vattern/stoutgatv2/ISO-enter.png

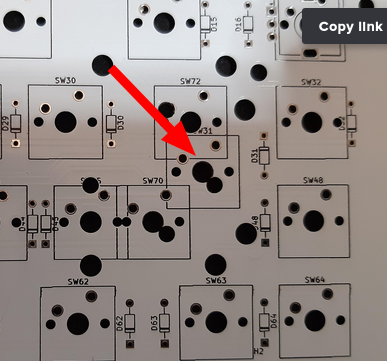
ISO-enter.png
