vattern/stoutgatv2/case/3d-print/Shell.stl

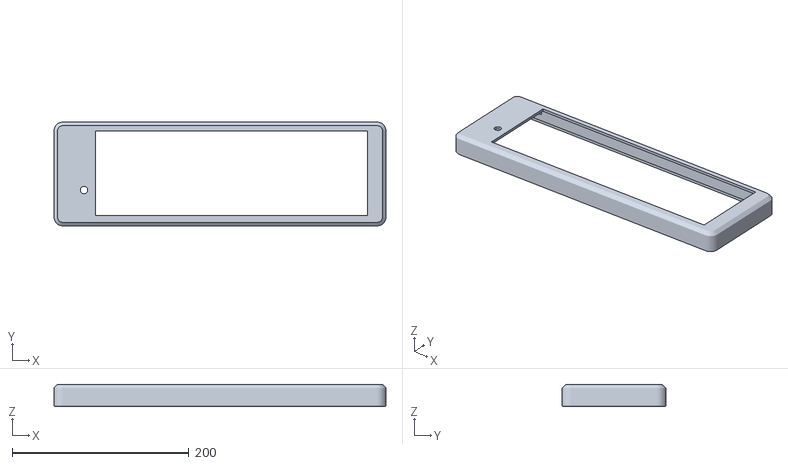
[picture p2: CAD file, 2021-02-21]
case/3d-print/Shell.stl
375.7 x 117.5 x 25.0
