vattern/stoutgatv2/case/acrylic/acrylic-layers.dxf

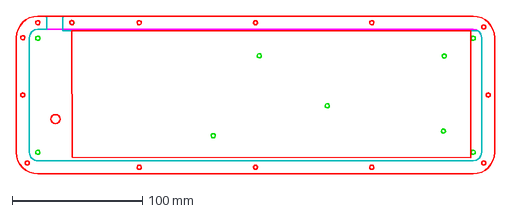
[picture p3: CAD file, 2021-02-21]
case/acrylic/acrylic-layers.dxf
366.8 x 121.0 mm
