vattern/stoutgatv2/gerbers/stoutgat-outline-Edge_Cuts.dxf

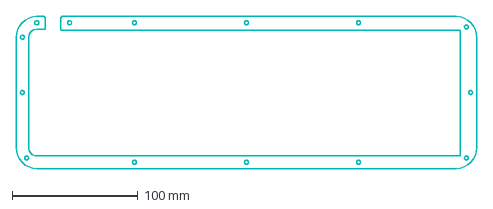
[picture p4: CAD file, 2020-09-12]
gerbers/stoutgat-outline-Edge_Cuts.dxf
366.8 x 121.0 mm
