vattern/stoutgatv2/stoutgatv2.step

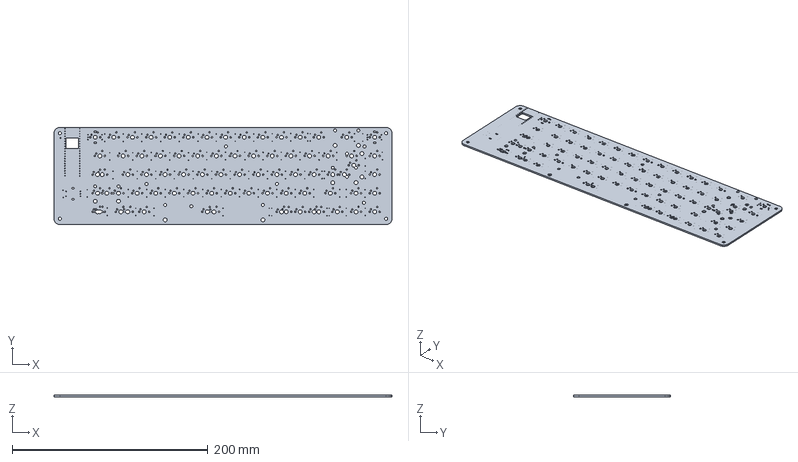
[picture p5: CAD file, 2020-09-12]
stoutgatv2.step
345.7 x 99.5 x 1.60 mm
