vattern/stoutgatv2/case/3d-print/Base.stl

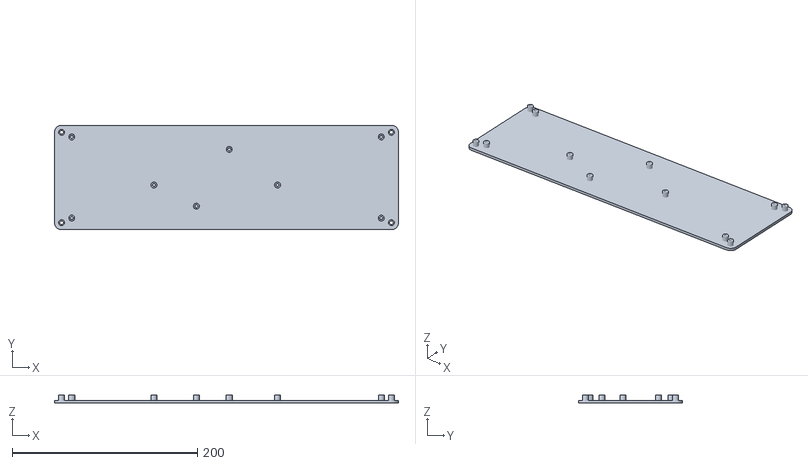
[picture p6: CAD file, 2021-02-21]
case/3d-print/Base.stl
370.9 x 112.7 x 9.00
