vattern/stoutgatv2/gerbers/stoutgatv2-Edge_Cuts.dxf

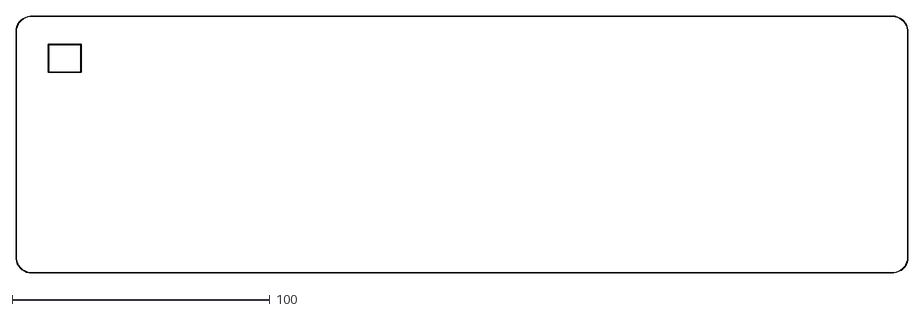
[picture p7: CAD file, 2020-08-15]
gerbers/stoutgatv2-Edge_Cuts.dxf
345.8 x 99.5
