vattern/stoutgatv2/case/3d-print/old-version-ymmv/bottom - left.stl

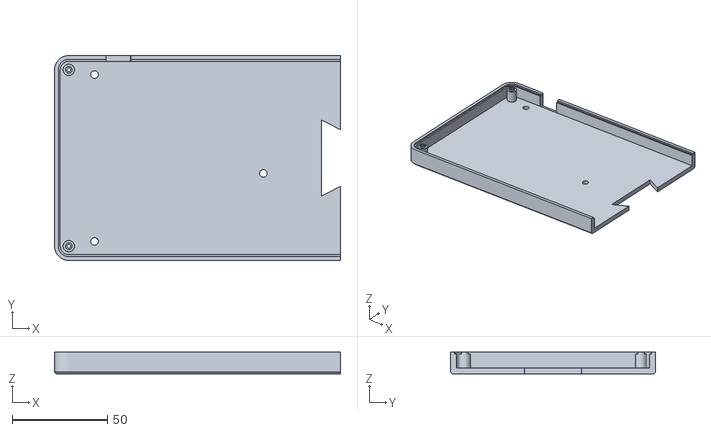
[picture p8: CAD file, 2020-09-12, an earlier design]
case/3d-print/old-version-ymmv/bottom - left.stl
150.0 x 107.5 x 11.5
