vattern/stoutgatv2/case/3d-print/old-version-ymmv/bottom-mid.stl

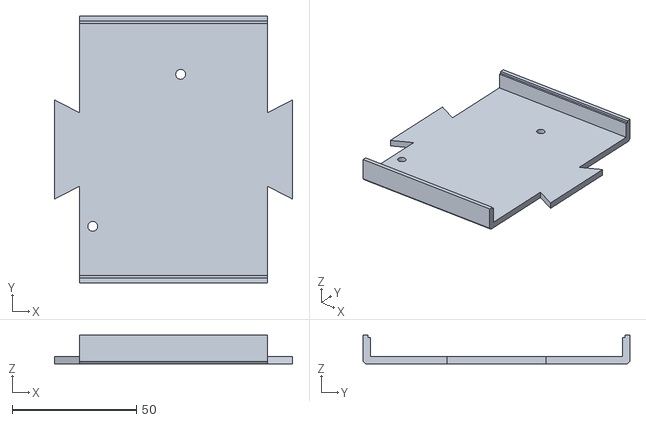
[picture p9: CAD file, 2020-09-12, an earlier design]
case/3d-print/old-version-ymmv/bottom-mid.stl
95.9 x 107.5 x 11.5
