vattern/stoutgatv2/case/3d-print/old-version-ymmv/top mid rear.stl

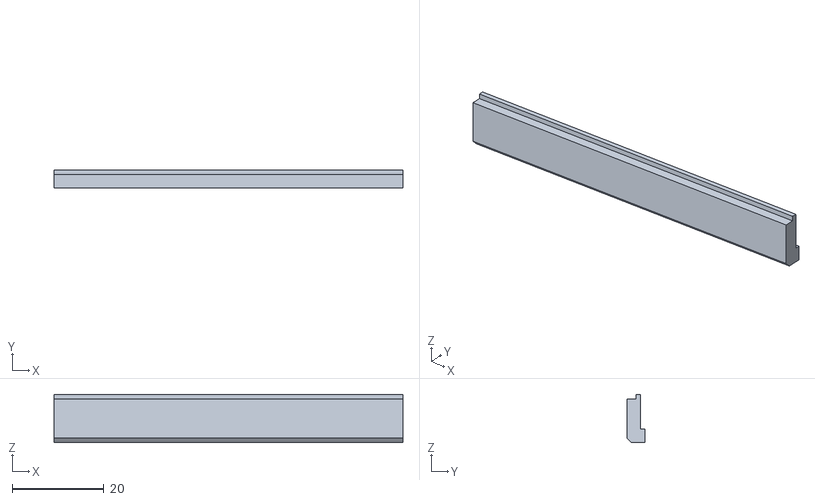
[picture p10: CAD file, 2020-09-12, an earlier design]
case/3d-print/old-version-ymmv/top mid rear.stl
75.9 x 4.00 x 10.5
