vattern/stoutgatv2/case/3d-print/old-version-ymmv/top - right.stl

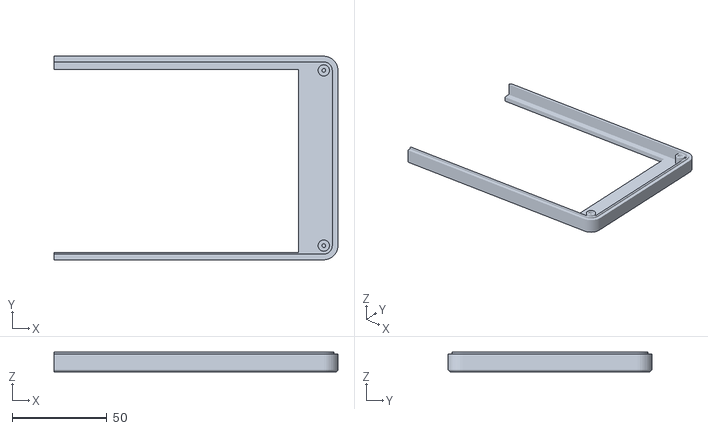
[picture p11: CAD file, 2020-09-12, an earlier design]
case/3d-print/old-version-ymmv/top - right.stl
149.8 x 107.5 x 10.5
