vattern/stoutgatv2/case/3d-print/old-version-ymmv/top - left.stl

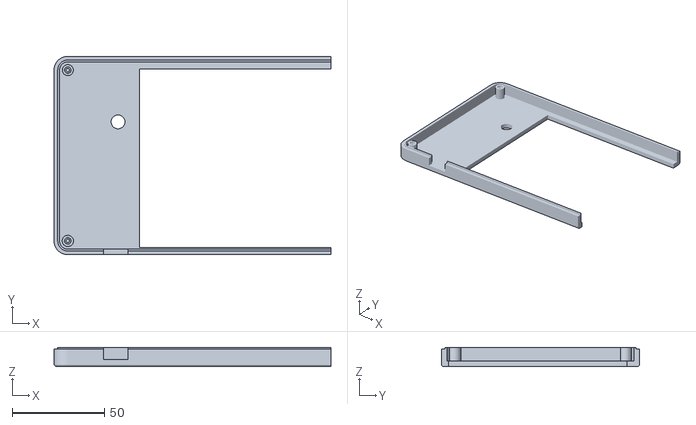
[picture p12: CAD file, 2020-09-12, an earlier design]
case/3d-print/old-version-ymmv/top - left.stl
150.0 x 107.5 x 10.5
