vattern/stoutgatv2/case/3d-print/old-version-ymmv/top mid front.stl

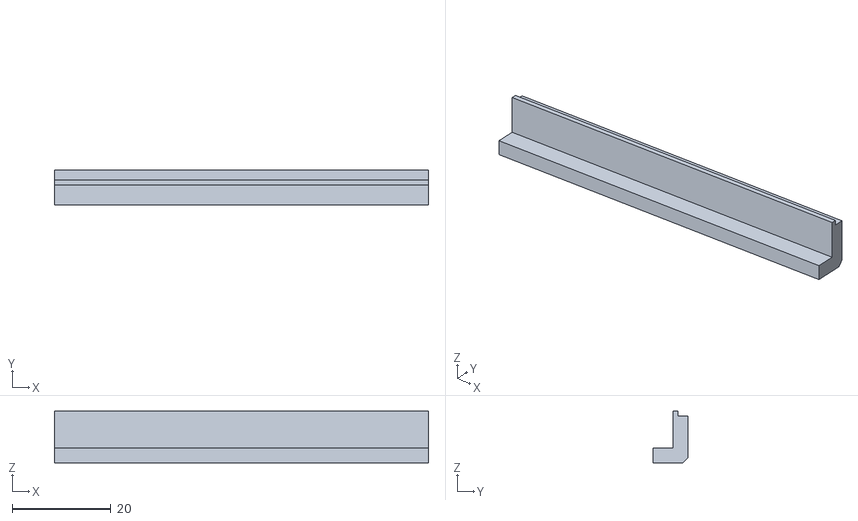
[picture p13: CAD file, 2020-09-12, an earlier design]
case/3d-print/old-version-ymmv/top mid front.stl
75.9 x 7.00 x 10.5
