vattern/stoutgatv2/(list of files, cad)

Other CAD files:
gerbers/stoutgat-outline-Dwgs_User.dxf
case/3d-print/old-version-ymmv/bottom - right.stl
case/3d-print/old-version-ymmv/stoutgatv2 v20.f3d
gerbers/#stoutgat-outline-Edge_Cuts.dxf
