vattern/stoutgatv2/stoutgatv2.kicad_pcb

## KiCad design stoutgatv2.kicad_pcb (2020-09-12)

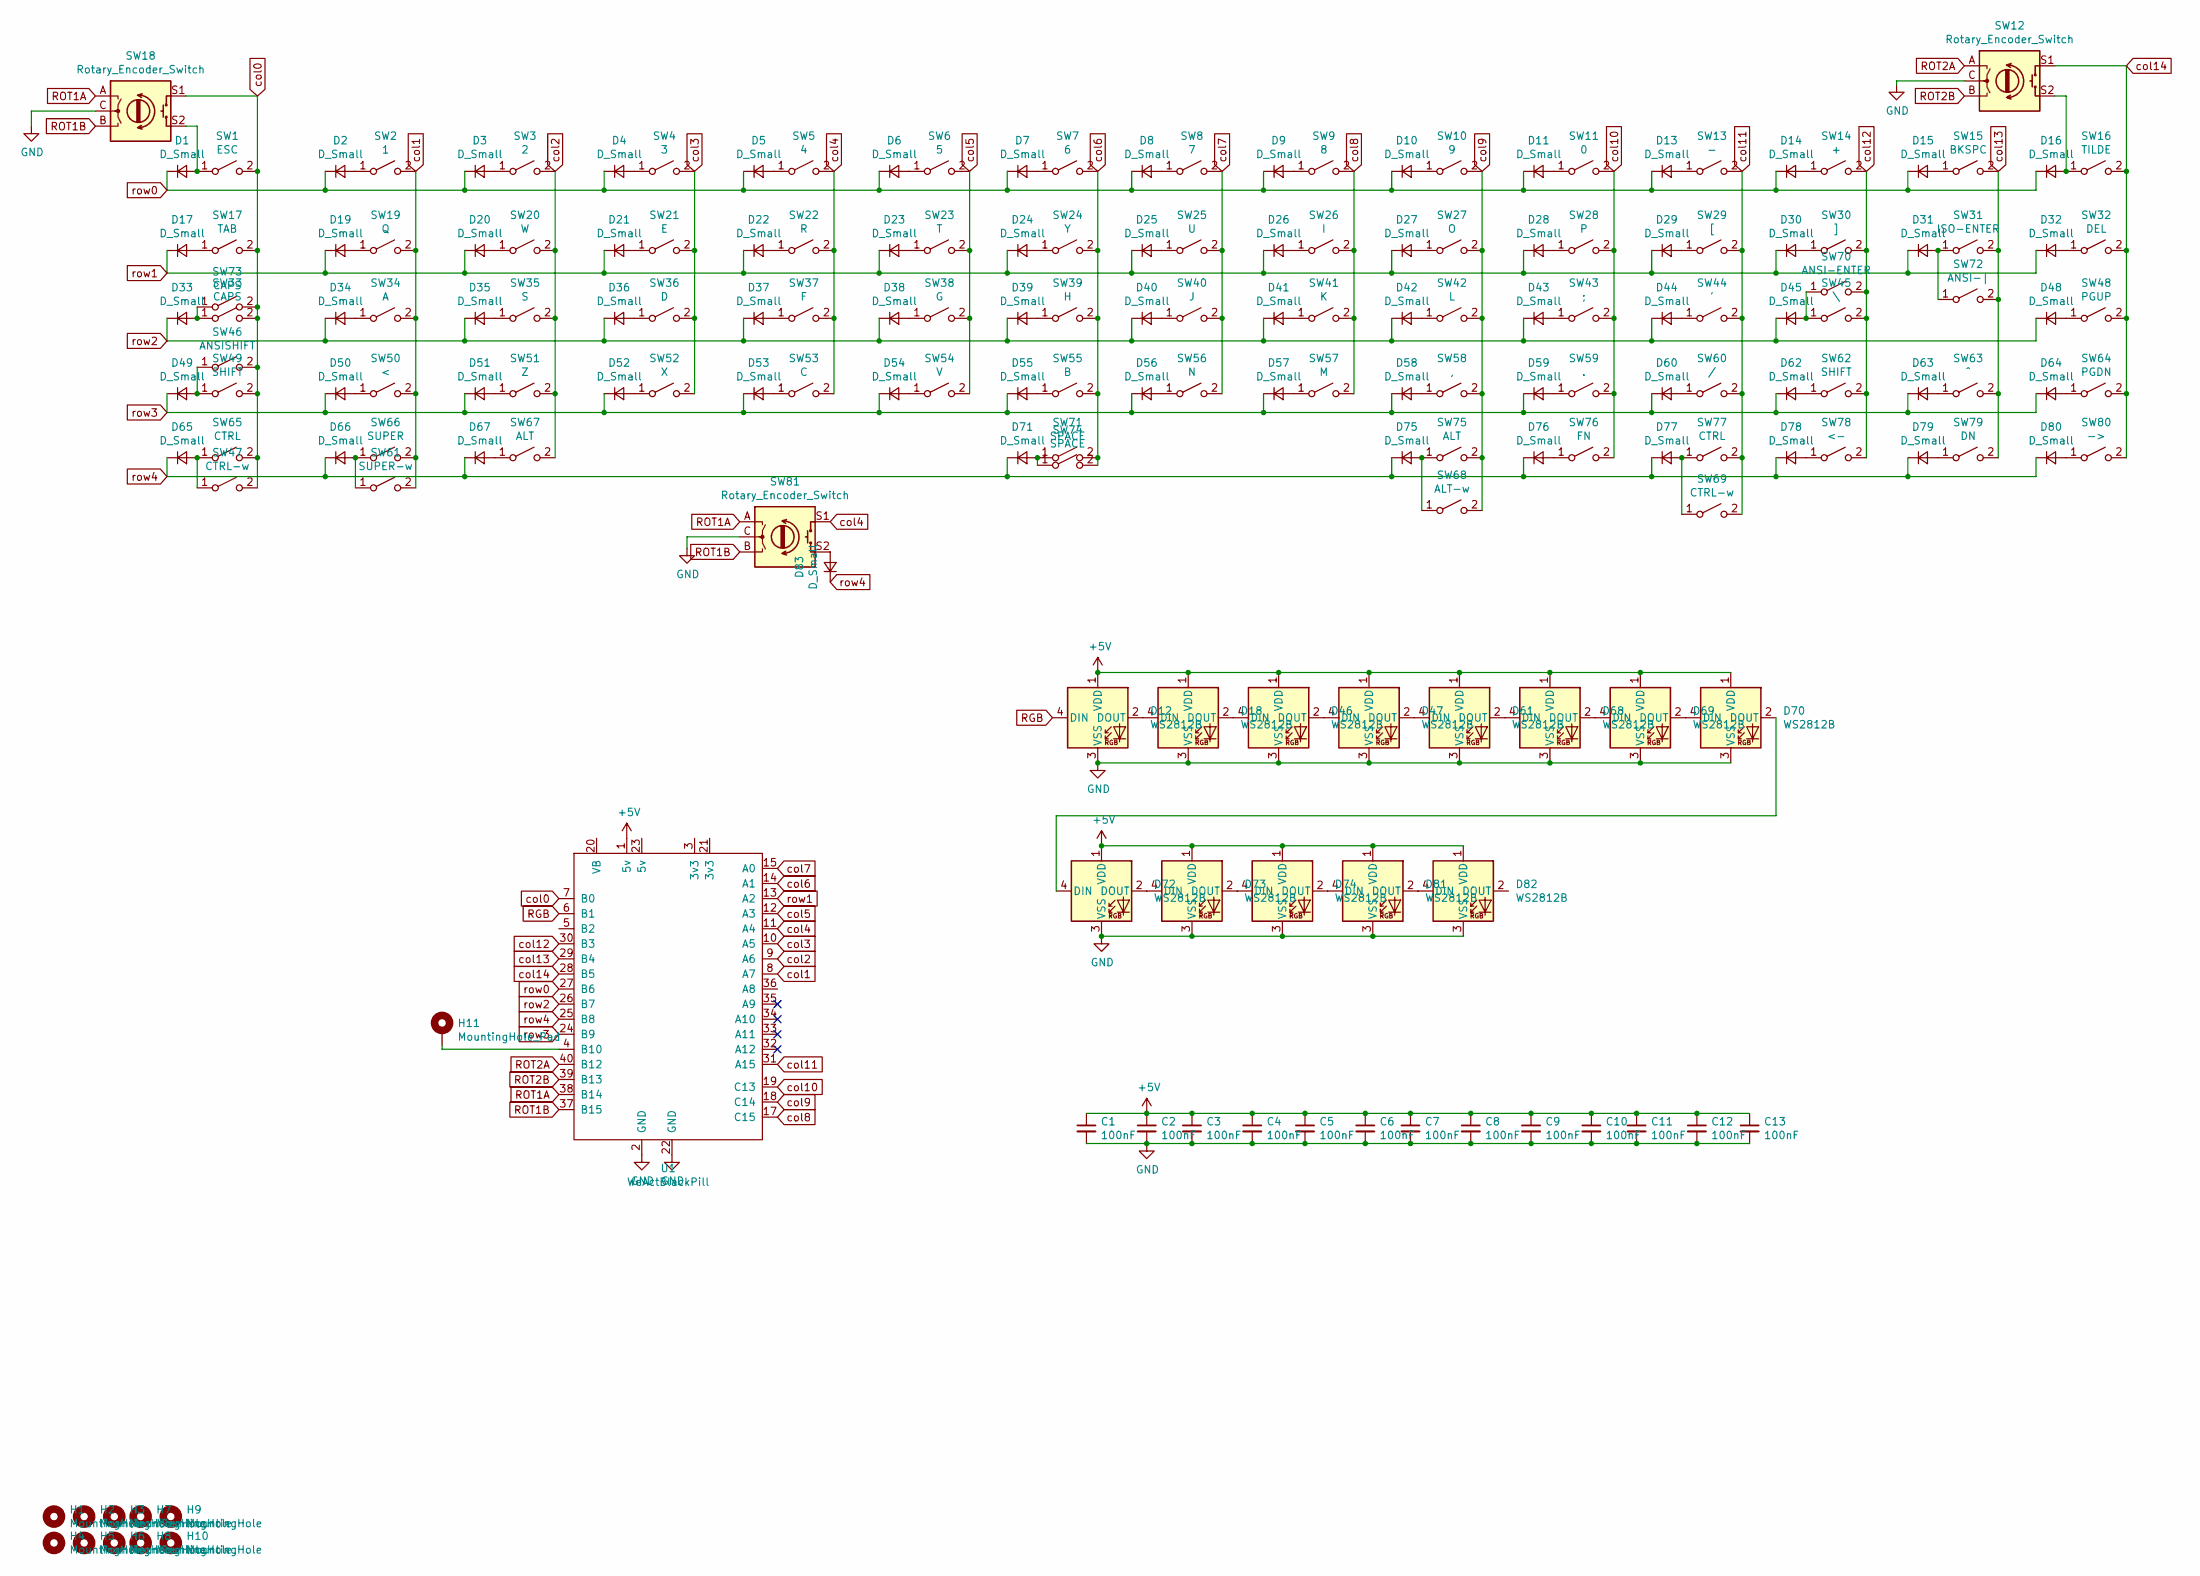
[picture p14: schematic stoutgatv2.sch, Stoutgat]

Parts:
C1, C2, C3, C4, C5, C6, C7, C8, C9, C10, C11, C12, C13: 100nF; C_0805_2012Metric
D1, D2, D3, D4, D5, D6, D7, D8, D9, D10, D11, D13, D14, D15, D16, D17, D19, D20, D21, D22, D23, D24, D25, D26, D27, D28, D29, D30, D31, D32, D33, D34, D35, D36, D37, D38, D39, D40, D41, D42, D43, D44, D45, D48, D49, D50, D51, D52, D53, D54, D55, D56, D57, D58, D59, D60, D62, D63, D64, D65, D66, D67, D71, D75, D76, D77, D78, D79, D80, D83: D_Small; D_DO-34_SOD68_P7.62mm_Horizontal
D12, D18, D46, D47, D61, D68, D69, D70, D72, D73, D74, D81, D82: WS2812B; LED_WS2812B_PLCC4_5.0x5.0mm_P3.2mm
H1, H2, H3, H4, H5, H6, H7, H8, H9, H10: MountingHole; MountingHole_3.2mm_M3
H11: MountingHole_Pad; TestPoint_Loop_D2.50mm_Drill1.0mm
SW1: ESC; SW_Cherry_MX_1.00u_PCB
SW2: 1; SW_Cherry_MX_1.00u_PCB
SW3: 2; SW_Cherry_MX_1.00u_PCB
SW4: 3; SW_Cherry_MX_1.00u_PCB
SW5: 4; SW_Cherry_MX_1.00u_PCB
SW6: 5; SW_Cherry_MX_1.00u_PCB
SW7: 6; SW_Cherry_MX_1.00u_PCB
SW8: 7; SW_Cherry_MX_1.00u_PCB
SW9: 8; SW_Cherry_MX_1.00u_PCB
SW10: 9; SW_Cherry_MX_1.00u_PCB
SW11: 0; SW_Cherry_MX_1.00u_PCB
SW12, SW18, SW81: Rotary_Encoder_Switch; RotaryEncoder_Alps_EC11E-Switch_Vertical_H20mm
SW13: -; SW_Cherry_MX_1.00u_PCB
SW14: +; SW_Cherry_MX_1.00u_PCB
SW15: BKSPC; SW_Cherry_MX_2.00u_PCB
SW16: TILDE; SW_Cherry_MX_1.00u_PCB
SW17: TAB; SW_Cherry_MX_1.50u_PCB
SW19: Q; SW_Cherry_MX_1.00u_PCB
SW20: W; SW_Cherry_MX_1.00u_PCB
SW21: E; SW_Cherry_MX_1.00u_PCB
SW22: R; SW_Cherry_MX_1.00u_PCB
SW23: T; SW_Cherry_MX_1.00u_PCB
SW24: Y; SW_Cherry_MX_1.00u_PCB
SW25: U; SW_Cherry_MX_1.00u_PCB
SW26: I; SW_Cherry_MX_1.00u_PCB
SW27: O; SW_Cherry_MX_1.00u_PCB
SW28: P; SW_Cherry_MX_1.00u_PCB
SW29: [; SW_Cherry_MX_1.00u_PCB
SW30: ]; SW_Cherry_MX_1.00u_PCB
SW31: ISO-ENTER; SW_Cherry_MX_ISOEnter_PCB
SW32: DEL; SW_Cherry_MX_1.00u_PCB
SW33: CAPS; SW_Cherry_MX_1.75u_PCB
SW34: A; SW_Cherry_MX_1.00u_PCB
SW35: S; SW_Cherry_MX_1.00u_PCB
SW36: D; SW_Cherry_MX_1.00u_PCB
SW37: F; SW_Cherry_MX_1.00u_PCB
SW38: G; SW_Cherry_MX_1.00u_PCB
SW39: H; SW_Cherry_MX_1.00u_PCB
SW40: J; SW_Cherry_MX_1.00u_PCB
SW41: K; SW_Cherry_MX_1.00u_PCB
SW42: L; SW_Cherry_MX_1.00u_PCB
SW43: ;; SW_Cherry_MX_1.00u_PCB
SW44: '; SW_Cherry_MX_1.00u_PCB
SW45: \\; SW_Cherry_MX_1.00u_PCB
SW46: ANSISHIFT; SW_Cherry_MX_2.25u_PCB
SW47, SW69: CTRL-w; SW_Cherry_MX_1.50u_PCB
SW48: PGUP; SW_Cherry_MX_1.00u_PCB
SW49: SHIFT; SW_Cherry_MX_1.25u_PCB
SW50: <; SW_Cherry_MX_1.00u_PCB
SW51: Z; SW_Cherry_MX_1.00u_PCB
SW52: X; SW_Cherry_MX_1.00u_PCB
SW53: C; SW_Cherry_MX_1.00u_PCB
SW54: V; SW_Cherry_MX_1.00u_PCB
SW55: B; SW_Cherry_MX_1.00u_PCB
SW56: N; SW_Cherry_MX_1.00u_PCB
SW57: M; SW_Cherry_MX_1.00u_PCB
SW58: ,; SW_Cherry_MX_1.00u_PCB
SW59: .; SW_Cherry_MX_1.00u_PCB
SW60: /; SW_Cherry_MX_1.00u_PCB
SW61: SUPER-w; SW_Cherry_MX_1.50u_PCB
SW62: SHIFT; SW_Cherry_MX_1.75u_PCB
SW63: ^; SW_Cherry_MX_1.00u_PCB
SW64: PGDN; SW_Cherry_MX_1.00u_PCB
SW65: CTRL; SW_Cherry_MX_1.25u_PCB
SW66: SUPER; SW_Cherry_MX_1.25u_PCB
SW67: ALT; SW_Cherry_MX_1.25u_PCB
SW68: ALT-w; SW_Cherry_MX_1.50u_PCB
SW70: ANSI-ENTER; SW_Cherry_MX_2.25u_PCB
SW71: SPACE; SW_Cherry_MX_6.25u_PCB
SW72: ANSI-|; SW_Cherry_MX_1.25u_PCB
SW73: CAPS; SW_Cherry_MX_1.25u_PCB
SW74: SPACE; SW_Cherry_MX_1.25u_PCB
SW75: ALT; SW_Cherry_MX_1.00u_PCB
SW76: FN; SW_Cherry_MX_1.00u_PCB
SW77: CTRL; SW_Cherry_MX_1.00u_PCB
SW78: <-; SW_Cherry_MX_1.00u_PCB
SW79: DN; SW_Cherry_MX_1.00u_PCB
SW80: ->; SW_Cherry_MX_1.00u_PCB
U1: WeActBlackPill; Blackpill

Connections:
+5V: C1.1, C2.1, C3.1, C4.1, C5.1, C6.1, C7.1, C8.1, C9.1, C10.1, C11.1, C12.1, C13.1, D12.1 (VDD), D18.1 (VDD), D46.1 (VDD), D47.1 (VDD), D61.1 (VDD), D68.1 (VDD), D69.1 (VDD), D70.1 (VDD), D72.1 (VDD), D73.1 (VDD), D74.1 (VDD), D81.1 (VDD), D82.1 (VDD), U1.1 (5v)
GND: C1.2, C2.2, C3.2, C4.2, C5.2, C6.2, C7.2, C8.2, C9.2, C10.2, C11.2, C12.2, C13.2, D12.3 (VSS), D18.3 (VSS), D46.3 (VSS), D47.3 (VSS), D61.3 (VSS), D68.3 (VSS), D69.3 (VSS), D70.3 (VSS), D72.3 (VSS), D73.3 (VSS), D74.3 (VSS), D81.3 (VSS), D82.3 (VSS), SW12.C, SW18.C, SW81.C, U1.2 (GND), U1.22 (GND)
unnamed: D1.2 (A), SW1.1 (A), SW18.S2
unnamed: D2.2 (A), SW2.1 (A)
unnamed: D3.2 (A), SW3.1 (A)
unnamed: D4.2 (A), SW4.1 (A)
unnamed: D5.2 (A), SW5.1 (A)
unnamed: D6.2 (A), SW6.1 (A)
unnamed: D7.2 (A), SW7.1 (A)
unnamed: D8.2 (A), SW8.1 (A)
unnamed: D9.2 (A), SW9.1 (A)
unnamed: D10.2 (A), SW10.1 (A)
unnamed: D11.2 (A), SW11.1 (A)
unnamed: D12.2 (DOUT), D18.4 (DIN)
unnamed: D13.2 (A), SW13.1 (A)
unnamed: D14.2 (A), SW14.1 (A)
unnamed: D15.2 (A), SW15.1 (A)
unnamed: D16.2 (A), SW12.S2, SW16.1 (A)
unnamed: D17.2 (A), SW17.1 (A)
unnamed: D18.2 (DOUT), D46.4 (DIN)
unnamed: D19.2 (A), SW19.1 (A)
unnamed: D20.2 (A), SW20.1 (A)
unnamed: D21.2 (A), SW21.1 (A)
unnamed: D22.2 (A), SW22.1 (A)
unnamed: D23.2 (A), SW23.1 (A)
unnamed: D24.2 (A), SW24.1 (A)
unnamed: D25.2 (A), SW25.1 (A)
unnamed: D26.2 (A), SW26.1 (A)
unnamed: D27.2 (A), SW27.1 (A)
unnamed: D28.2 (A), SW28.1 (A)
unnamed: D29.2 (A), SW29.1 (A)
unnamed: D30.2 (A), SW30.1 (A)
unnamed: D31.2 (A), SW31.1 (A), SW72.1 (A)
unnamed: D32.2 (A), SW32.1 (A)
unnamed: D33.2 (A), SW33.1 (A), SW73.1 (A)
unnamed: D34.2 (A), SW34.1 (A)
unnamed: D35.2 (A), SW35.1 (A)
unnamed: D36.2 (A), SW36.1 (A)
unnamed: D37.2 (A), SW37.1 (A)
unnamed: D38.2 (A), SW38.1 (A)
unnamed: D39.2 (A), SW39.1 (A)
unnamed: D40.2 (A), SW40.1 (A)
unnamed: D41.2 (A), SW41.1 (A)
unnamed: D42.2 (A), SW42.1 (A)
unnamed: D43.2 (A), SW43.1 (A)
unnamed: D44.2 (A), SW44.1 (A)
unnamed: D45.2 (A), SW45.1 (A), SW70.1 (A)
unnamed: D46.2 (DOUT), D47.4 (DIN)
unnamed: D47.2 (DOUT), D61.4 (DIN)
unnamed: D48.2 (A), SW48.1 (A)
unnamed: D49.2 (A), SW46.1 (A), SW49.1 (A)
unnamed: D50.2 (A), SW50.1 (A)
unnamed: D51.2 (A), SW51.1 (A)
unnamed: D52.2 (A), SW52.1 (A)
unnamed: D53.2 (A), SW53.1 (A)
unnamed: D54.2 (A), SW54.1 (A)
unnamed: D55.2 (A), SW55.1 (A)
unnamed: D56.2 (A), SW56.1 (A)
unnamed: D57.2 (A), SW57.1 (A)
unnamed: D58.2 (A), SW58.1 (A)
unnamed: D59.2 (A), SW59.1 (A)
unnamed: D60.2 (A), SW60.1 (A)
unnamed: D61.2 (DOUT), D68.4 (DIN)
unnamed: D62.2 (A), SW62.1 (A)
unnamed: D63.2 (A), SW63.1 (A)
unnamed: D64.2 (A), SW64.1 (A)
unnamed: D65.2 (A), SW47.1 (A), SW65.1 (A)
unnamed: D66.2 (A), SW61.1 (A), SW66.1 (A)
unnamed: D67.2 (A), SW67.1 (A)
unnamed: D68.2 (DOUT), D69.4 (DIN)
unnamed: D69.2 (DOUT), D70.4 (DIN)
unnamed: D70.2 (DOUT), D72.4 (DIN)
unnamed: D71.2 (A), SW71.1 (A), SW74.1 (A)
unnamed: D72.2 (DOUT), D73.4 (DIN)
unnamed: D73.2 (DOUT), D74.4 (DIN)
unnamed: D74.2 (DOUT), D81.4 (DIN)
unnamed: D75.2 (A), SW68.1 (A), SW75.1 (A)
unnamed: D76.2 (A), SW76.1 (A)
unnamed: D77.2 (A), SW69.1 (A), SW77.1 (A)
unnamed: D78.2 (A), SW78.1 (A)
unnamed: D79.2 (A), SW79.1 (A)
unnamed: D80.2 (A), SW80.1 (A)
unnamed: D81.2 (DOUT), D82.4 (DIN)
unnamed: D83.2 (A), SW81.S2
unnamed: H11.1, U1.4 (B10)
RGB: D12.4 (DIN), U1.6 (B1)
ROT1A: SW18.A, SW81.A, U1.38 (B14)
ROT1B: SW18.B, SW81.B, U1.37 (B15)
ROT2A: SW12.A, U1.40 (B12)
ROT2B: SW12.B, U1.39 (B13)
col0: SW1.2 (B), SW17.2 (B), SW18.S1, SW33.2 (B), SW46.2 (B), SW47.2 (B), SW49.2 (B), SW65.2 (B), SW73.2 (B), U1.7 (B0)
col1: SW2.2 (B), SW19.2 (B), SW34.2 (B), SW50.2 (B), SW61.2 (B), SW66.2 (B), U1.8 (A7)
col2: SW3.2 (B), SW20.2 (B), SW35.2 (B), SW51.2 (B), SW67.2 (B), U1.9 (A6)
col3: SW4.2 (B), SW21.2 (B), SW36.2 (B), SW52.2 (B), U1.10 (A5)
col4: SW5.2 (B), SW22.2 (B), SW37.2 (B), SW53.2 (B), SW81.S1, U1.11 (A4)
col5: SW6.2 (B), SW23.2 (B), SW38.2 (B), SW54.2 (B), U1.12 (A3)
col6: SW7.2 (B), SW24.2 (B), SW39.2 (B), SW55.2 (B), SW71.2 (B), SW74.2 (B), U1.14 (A1)
col7: SW8.2 (B), SW25.2 (B), SW40.2 (B), SW56.2 (B), U1.15 (A0)
col8: SW9.2 (B), SW26.2 (B), SW41.2 (B), SW57.2 (B), U1.17 (C15)
col9: SW10.2 (B), SW27.2 (B), SW42.2 (B), SW58.2 (B), SW68.2 (B), SW75.2 (B), U1.18 (C14)
col10: SW11.2 (B), SW28.2 (B), SW43.2 (B), SW59.2 (B), SW76.2 (B), U1.19 (C13)
col11: SW13.2 (B), SW29.2 (B), SW44.2 (B), SW60.2 (B), SW69.2 (B), SW77.2 (B), U1.31 (A15)
col12: SW14.2 (B), SW30.2 (B), SW45.2 (B), SW62.2 (B), SW70.2 (B), SW78.2 (B), U1.30 (B3)
col13: SW15.2 (B), SW31.2 (B), SW63.2 (B), SW72.2 (B), SW79.2 (B), U1.29 (B4)
col14: SW12.S1, SW16.2 (B), SW32.2 (B), SW48.2 (B), SW64.2 (B), SW80.2 (B), U1.28 (B5)
row0: D1.1 (K), D2.1 (K), D3.1 (K), D4.1 (K), D5.1 (K), D6.1 (K), D7.1 (K), D8.1 (K), D9.1 (K), D10.1 (K), D11.1 (K), D13.1 (K), D14.1 (K), D15.1 (K), D16.1 (K), U1.27 (B6)
row1: D17.1 (K), D19.1 (K), D20.1 (K), D21.1 (K), D22.1 (K), D23.1 (K), D24.1 (K), D25.1 (K), D26.1 (K), D27.1 (K), D28.1 (K), D29.1 (K), D30.1 (K), D31.1 (K), D32.1 (K), U1.13 (A2)
row2: D33.1 (K), D34.1 (K), D35.1 (K), D36.1 (K), D37.1 (K), D38.1 (K), D39.1 (K), D40.1 (K), D41.1 (K), D42.1 (K), D43.1 (K), D44.1 (K), D45.1 (K), D48.1 (K), U1.26 (B7)
row3: D49.1 (K), D50.1 (K), D51.1 (K), D52.1 (K), D53.1 (K), D54.1 (K), D55.1 (K), D56.1 (K), D57.1 (K), D58.1 (K), D59.1 (K), D60.1 (K), D62.1 (K), D63.1 (K), D64.1 (K), U1.24 (B9)
row4: D65.1 (K), D66.1 (K), D67.1 (K), D71.1 (K), D75.1 (K), D76.1 (K), D77.1 (K), D78.1 (K), D79.1 (K), D80.1 (K), D83.1 (K), U1.25 (B8)

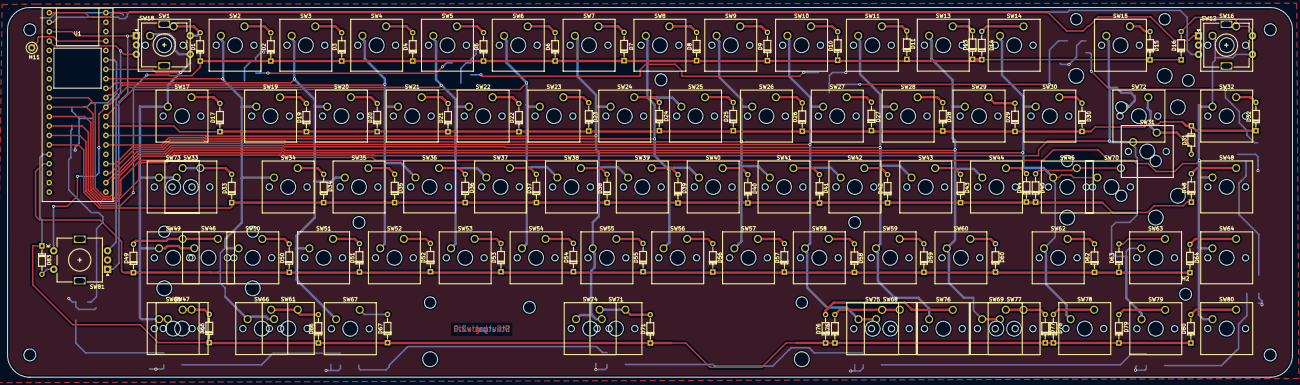
[picture p15: board stoutgatv2.kicad_pcb from above]

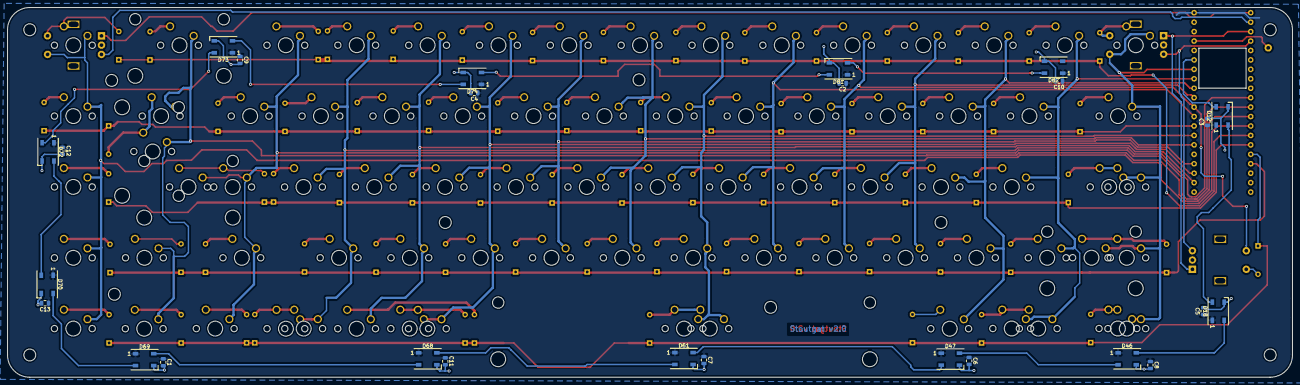
[picture p16: board stoutgatv2.kicad_pcb from below]

Board: 2 copper layers, 345.7 x 99.5 mm, 189 parts (26 on the bottom side), 110 nets.
