vattern/stoutgatv2/(commit log)

2020-08-08 Add PCBs
    [stoutgatv2-B_Cu.gbr, stoutgatv2-B_Mask.gbr, stoutgatv2-B_Paste.gbr, stoutgatv2-B_SilkS.gbr, stoutgatv2-Edge_Cuts.gbr, stoutgatv2-F_Cu.gbr, stoutgatv2-F_Mask.gbr, stoutgatv2-F_Paste.gbr]
2020-08-15 JLC tweaks
    [stoutgatv2.kicad_pcb]
2020-09-12 adding case files
    [acrylic-layers.dxf, bottom - left.stl, bottom - right.stl, bottom-mid.stl, stoutgat-outline-Edge_Cuts.dxf, stoutgatv2 v20.f3d, stoutgatv2.kicad_pcb, stoutgatv2.step]
2020-09-20 Update cutout layer to no longer overlap mounting hardware
    [acrylic-layers.dxf]
2021-02-21 case update
    [bottom - left.stl, bottom - right.stl, bottom-mid.stl, stoutgatv2 v20.f3d, top - left.stl, top - right.stl, top mid front.stl, top mid rear.stl]
